makerPIF/Catamaran/daejeon-ESP32usv/daejeon-ESPusv/docs/01-HARDWARE.md

# 01 · 하드웨어

[← 저장소 홈으로](../README.md)

- [1. A2212 10T 1400KV 적합성 검증](#1-a2212-10t-1400kv-적합성-검증)
- [2. 프로펠러 선정](#2-프로펠러-선정)
- [3. 부품표 (BOM)](#3-부품표-bom)
- [3-1. 카메라 보드 — 둘 중 무엇을 쓸까](#3-1-카메라-보드--둘-중-무엇을-쓸까)
- [4. ESP32 핀 배치](#4-esp32-핀-배치)
- [5. 전원 계통](#5-전원-계통)
- [6. 배터리 전압 측정 회로](#6-배터리-전압-측정-회로)
- [7. ESC를 후진 가능하게 만들기](#7-esc를-후진-가능하게-만들기)

---

## 1. A2212 10T 1400KV 적합성 검증

결론부터 — **"어디에 다느냐"에 따라 답이 정반대로 갈립니다.**

### ✅ 수면 위 에어프로펠러(에어보트) 방식 — 적합

A2212 10T 1400KV는 원래 소형 비행기·드론용 아웃러너입니다. **공기를 미는 프로펠러를 돌리는 것이
이 모터의 설계 목적**이므로, 3S 배터리 + 8×4.5″ 프로펠러 조합에서 정격 안쪽으로 여유 있게 동작합니다.

### ❌ 수중 프로펠러 직결 방식 — 쓰지 말 것

두 가지 이유입니다.

1. **구조** — 아웃러너는 케이스가 열려 있어 물이 그대로 들어갑니다. 방수 코팅을 해도 베어링과 권선이 곧 부식됩니다.
2. **부하** — 물은 공기보다 약 800배 무겁습니다. 1400KV의 고회전·저토크 특성으로 수중 프로펠러를
   돌리면 전류가 정격을 크게 넘겨 모터와 ESC가 함께 타버립니다.

수중 추진에는 500~900KV 저KV 방수 모터를 씁니다. 중학생 초심자에게는 방수 처리·스터핑 박스·축 정렬이
모두 난관이라 이 프로젝트에서는 선택하지 않았습니다.

### 계산으로 확인하기

| 항목 | 계산 | 결과 | 기준 | 판정 |
|---|---|---|---|---|
| 모터 1개 최대 전력 | `11.1 V × 13 A` | **144.3 W** | 정격 180 W | ✅ 여유 20 % |
| ESC 전류 여유율 | `30 A ÷ 13 A` | **2.31 배** | 1.5배 이상 | ✅ 충분 |
| 총 정지 추력 | `780 gf × 2` | **1,560 gf** | — | — |
| 추력 대 중량비 | `1,560 gf ÷ 2.4 kg` | **0.62** | 0.3 이상 | ✅ 2배 여유 |
| 순항(55 %) 소비전류 | `13 A × 2 × 0.55³ + 0.6 A` | **4.9 A** | — | — |
| 실운용 시간 | `5.0 Ah ÷ 4.9 A × 0.8 × 0.7` | **34 분** | 15분 이상 | ✅ 양호 |
| 무부하 최대 회전수 | `1400 KV × 11.1 V` | **15,540 rpm** | — | ⚠ 가드 필수 |

> 배는 항공기와 달리 추력/중량비가 1을 넘길 필요가 없습니다. 물 위에 뜬 상태에서 **항주 저항만
> 이기면 되므로 0.3 이상이면 충분**합니다. 0.62는 가속과 맞바람에 쓸 여유가 두 배라는 뜻입니다.

추력·전류는 A2212 1400KV + 8×4.5″ + 3S 조합의 공개 실측 참고치입니다.
`hardware/대전중앙중_USV_BOM.xlsx` 의 **추진성능계산** 시트에서 노란 칸을 바꾸면 전부 다시 계산됩니다.
완성 후 주방저울로 실제 추력을 재서 그 값을 우리 기체 실측치로 바꾸면 정확해집니다.

---

## 2. 프로펠러 선정

| 프로펠러 | 배터리 | 추력/개 | 전류/개 | 평가 |
|---|---|---|---|---|
| **8045 (8×4.5″)** | 3S | ≈780 gf | ≈13 A | ✅ **1순위 · 표준 조합.** 추력·전류·소음의 균형이 가장 좋습니다 |
| 8060 (8×6″) | 3S | ≈850 gf | ≈15 A | 🟡 2순위. 최고속도는 조금 오르지만 발열이 커집니다. 3S에서의 상한선 |
| 7038 (7×3.8″) | 3S | ≈580 gf | ≈9 A | 🟡 장시간 운용용. 추력을 줄이는 대신 운용시간이 1.4배 늘어납니다 |
| 1045 (10×4.5″) | **2S 전용** | ≈520 gf | ≈10 A | ❌ **3S 금지.** 3S에 물리면 18~20 A로 정격을 넘겨 모터가 탑니다 |

> [!IMPORTANT]
> **좌·우에 CW(정회전) 1개, CCW(역회전) 1개를 나눠 다세요.**
> 두 프로펠러가 같은 방향으로 돌면 반작용 토크가 한쪽으로 쌓여 배가 계속 한쪽으로 기울고 돌아갑니다.
> 허브는 `3.17 mm`, 재질은 나일론+유리섬유(물 튀김·충격에 강함)를 고르세요.

> [!WARNING]
> 15,540 rpm으로 도는 프로펠러는 손가락을 벱니다. **프로펠러 가드 없이는 절대 전원을 넣지 마세요.**
> 가드는 3D 프린팅으로 함께 출력합니다([02-BUILD.md](02-BUILD.md)).

---

## 3. 부품표 (BOM)

전체 48개 품목과 소계·예산 비율은 [`hardware/대전중앙중_USV_BOM.xlsx`](../hardware/대전중앙중_USV_BOM.xlsx) 에 있습니다.
(`hardware/build_bom.py` 를 실행하면 다시 생성됩니다.)

★ 표시는 안전 또는 성능상 반드시 지켜야 하는 항목입니다.

### A. 추진계 — 90,800원

| 부품 | 규격 | 수량 | 단가 | 비고 |
|---|---|---:|---:|---|
| BLDC 모터 A2212 10T | 1400KV / 2–3S / 180W·14A / 축 3.17mm | 2 | 13,000 | ★ 에어프로펠러 전용 |
| ESC 30A (BLHeli_S) | 2–4S, BEC 5V 2A | 2 | 18,000 | ★ BLHeli_S여야 3D 모드 가능 |
| 프로펠러 8045 CW/CCW | 8×4.5″ 나일론+GF, 허브 3.17mm | 3세트 | 4,000 | 파손 대비 여유분 |
| BLHeli USB 링커 | SILABS C2 / 1-wire | 1 | 12,000 | 팀당 1개면 충분 |
| 3.5mm 바나나 커넥터 | 금도금 암/수 | 6 | 800 | 모터–ESC 연결 |
| 모터 마운트 (3D 프린팅) | PETG, 16mm 볼트 패턴 | 2 | — | 자체 제작 |
| 프로펠러 안전 가드 (3D 프린팅) | 내경 Ø225mm | 2 | — | ★ 안전상 필수 |

### B. 제어·센서 — 86,300원

| 부품 | 규격 | 수량 | 단가 |
|---|---|---:|---:|
| ESP32 NodeMCU DevKit V1 | ESP32-WROOM-32, 30핀 | 1 | 12,000 |
| MPU6050 (GY-521) | 6축 IMU, I2C | 1 | 3,000 |
| u-blox NEO-8M GPS | 세라믹 안테나 포함, 9600bps | 1 | 22,000 |
| 카메라 보드 ⓐ XIAO ESP32S3 Sense | OV2640 + PSRAM 8MB | 1 | 32,000 |
| 카메라 보드 ⓑ ESP32-CAM AI-Thinker | OV2640 + PSRAM 4MB (+ USB-TTL 어댑터 7,000원) | 1 | 9,000 |
| 능동 부저 5V | 3.3V 구동 가능형 | 1 | 1,000 |
| 저항 100kΩ / 22kΩ (1%) | 1/4W | 4 | 200 |
| 만능기판 + 핀헤더 + 점퍼선 | 5×7cm | 1 | 8,000 |
| XT60 커넥터 암/수 | — | 3 | 2,500 |

### C. 전원 — 195,000원

| 부품 | 규격 | 수량 | 단가 | 비고 |
|---|---|---:|---:|---|
| LiPo 배터리 3S 5000mAh 30C | 11.1V, XT60 | 2 | 55,000 | ★ 3S 고정 |
| UBEC 5V 3A (스위칭) | 입력 2–6S | 2 | 9,000 | 전원 계통 분리용 |
| LiPo 밸런스 충전기 | IMAX B6 급 | 1 | 45,000 | 학교 보유 시 제외 |
| 방수 토글 스위치 | 12V 20A 이상 | 1 | 4,000 | |
| XT60 병렬 분배 하네스 | 1→3 분기 | 1 | 6,000 | |
| LiPo 안전 보관 가방 | 방염 | 1 | 8,000 | ★ 안전상 필수 |
| 배터리 잔량 체커 | 1–8S | 1 | 4,000 | |

### D. 통신 — 246,000원

| 부품 | 규격 | 수량 | 단가 | 비고 |
|---|---|---:|---:|---|
| 미니 공유기 GL.iNet GL-AR300M16-Ext | OpenWrt / 외장안테나 2 / 5V | 1 | 45,000 | USV 탑재 |
| 2.4GHz 5dBi 무지향 안테나 | RP-SMA | 2 | 6,000 | USV 측 |
| 지상국 USB 무선랜 | ALFA AWUS036NHA 급 | 1 | 55,000 | ★ 장거리의 핵심 |
| 2.4GHz 14dBi 지향성 패널 | RP-SMA, 실외형 | 1 | 35,000 | ★ USV를 향해 조준 |
| RP-SMA 저손실 케이블 3m | LMR-195 급 | 2 | 12,000 | 짧을수록 좋음 |
| 안테나 거치용 삼각대 | 1.5m 이상 | 1 | 25,000 | 높이 = 통달거리 |
| [선택] LoRa E22-900T22S | 920MHz 설정 필수 | 2 | 18,000 | 백업 텔레메트리 |
| [선택] 920MHz 안테나 | 3dBi SMA | 2 | 7,000 | |

### E. RC 조종 — 90,000원

| 부품 | 규격 | 수량 | 단가 | 비고 |
|---|---|---:|---:|---|
| FlySky FS-i6 + FS-iA6B | 2.4GHz 6채널, iBUS | 1 | 85,000 | ★ 비상 정지·수동 탈출 |
| AA 건전지 | 송신기용 | 4 | 5,000 | |

### F. 선체·기구 — 192,200원 / G. 공구·소모품 — 87,000원

PETG 필라멘트 3kg(84,000), TPU 0.5kg(25,000), IP65 인클로저(18,000), 케이블 그랜드 PG7 ×6,
알루미늄 각파이프 20×20 ×2, EPP 폼, M3 볼트·인서트 너트, 실리콘 실란트, 부틸 테이프, 벨크로.
공구는 납땜인두·열수축튜브·멀티미터·드라이버 세트·주방저울 5kg(추력 측정용).

---

## 3-1. 카메라 보드 — 둘 중 무엇을 쓸까

영상 모듈은 **ⓐ XIAO ESP32S3 Sense** 와 **ⓑ ESP32-CAM AI-Thinker** 두 가지를 모두 지원합니다.
펌웨어 파일만 골라 올리면 되고, 주소 체계(`192.168.8.30` · `/stream` · `/control`)가 같아서
**GCS는 전혀 고칠 필요가 없습니다.**

| 항목 | ⓐ XIAO ESP32S3 Sense | ⓑ ESP32-CAM AI-Thinker |
|---|---|---|
| 가격 | 약 32,000원 | 약 9,000원 (+ USB-TTL 7,000원) |
| USB 단자 | **있음** — 케이블만 꽂으면 업로드 | 없음 — FTDI 어댑터 필수 |
| 업로드 난이도 | 쉬움 | IO0–GND 점프 필요 |
| 외장 안테나 | 기본 제공 (커넥터 바로 사용) | 가능하지만 **납땜 개조** 필요 |
| 크기 / 무게 | 21 × 17 mm / 약 5 g | 40 × 27 mm / 약 20 g |
| PSRAM | 8 MB | 4 MB |
| 전원 민감도 | 둔감 | **매우 민감** (470 µF 커패시터 권장) |
| 발열 | 적음 | 많음 (방열판 권장) |
| 플래시 LED | 없음 | **있음** (GPIO4) — 저조도 회수용 탐조등 |
| 펌웨어 | `usv_cam_xiao.ino` | `usv_cam_esp32cam.ino` |

**이렇게 고르세요.**

- 처음 만드는 팀, 중학생이 직접 납땜한다면 → **ⓐ XIAO**.
  USB로 바로 업로드되고 전원 문제가 거의 없습니다. 실패할 구석이 적습니다.
- 예산을 아껴야 하거나 여러 대를 만든다면 → **ⓑ ESP32-CAM**.
  대당 2만원 넘게 절약되고, USB-TTL 어댑터는 팀당 1개만 있으면 됩니다.
- 이미 학교에 ESP32-CAM이 굴러다닌다면 → 당연히 **ⓑ**.
  메이커 교육 현장에서 가장 흔한 보드이기도 합니다.

> [!NOTE]
> BOM의 예산 합계(987,300원)는 ⓐ XIAO 기준입니다.
> ⓑ ESP32-CAM으로 바꾸면 **약 16,000원이 줄어듭니다.**

---

## 4. ESP32 핀 배치

| 핀 | 연결 대상 | 선 색 (일반) | 비고 |
|---|---|---|---|
| `GPIO25` | 좌현 ESC 신호 | 흰색 또는 노랑 | PWM 50 Hz |
| `GPIO26` | 우현 ESC 신호 | 흰색 또는 노랑 | PWM 50 Hz |
| `GPIO21` | MPU6050 SDA | — | I2C 400 kHz |
| `GPIO22` | MPU6050 SCL | — | — |
| `GPIO16` | NEO-8M 의 **TX** | — | 서로 엇갈려 연결 (RX↔TX) |
| `GPIO17` | NEO-8M 의 **RX** | — | 9600 bps |
| `GPIO4` | FS-iA6B 의 iBUS(SENS) 단자 | — | 신호선 1가닥만 |
| `GPIO34` | 전압 분배 회로 중점 | — | 입력 전용 핀 |
| `GPIO27` | 부저 (+) | — | — |
| `3V3` | MPU6050 VCC | 빨강 | 5V도 되지만 3.3V 권장 |
| `VIN` | UBEC #1 의 5V | 빨강 | — |
| `GND` | **모든 GND 공통** | 검정 | ESC·수신기·센서 전부 |

> [!CAUTION]
> **가장 흔한 실수 — ESC 두 개의 BEC(빨간 선)를 동시에 연결하지 마세요.**
> 두 ESC의 5V 출력이 서로 다른 값을 밀어내며 싸우다가 한쪽이 고장납니다.
> ESC 신호 커넥터 3가닥 중 **빨간 선을 뽑아서 절연**하고, 흰색(신호)과 검정(GND)만 ESP32에 연결하세요.
> 5V는 UBEC에서 받습니다.

---

## 5. 전원 계통

```
3S LiPo (11.1V 5000mAh)
   │
   └─[메인 스위치]─[XT60 분배]─┬─────────────────► ESC ×2  (11.1V 직결, BEC 빨간선 제거)
                              │
                              ├─[UBEC #1 → 5V 3A]─┬─► ESP32 (VIN)
                              │                    └─► MPU6050 · NEO-8M · FS-iA6B 수신기
                              │
                              └─[UBEC #2 → 5V 3A]─┬─► 미니 공유기
                                                   └─► 카메라 보드
```

**UBEC를 두 개 쓰는 이유** — 공유기와 카메라는 순간 소비전류가 크게 출렁입니다.
ESP32와 같은 5V 선을 쓰면 그 출렁임에 컨트롤러가 리셋될 수 있어, 전원 계통을 아예 갈라 놓습니다.

---

## 6. 배터리 전압 측정 회로

ESP32의 ADC는 3.3 V까지만 읽으므로 11.1 V를 저항 두 개로 나눠 넣습니다.

```
배터리(+) ──[100 kΩ]──┬──[22 kΩ]── GND
                      │
                      └──────────► GPIO34
```

분배비 `(100 + 22) / 22 = 5.545` → 만충 12.6 V일 때 GPIO34에는 **2.27 V**가 걸립니다.
펌웨어의 `VBAT_DIV_RATIO` 값이 이 5.545입니다.

멀티미터 실측값과 GCS 표시값이 다르면 `VBAT_CAL` 을 `실측 ÷ 표시` 로 넣어 보정하세요.

---

## 7. ESC를 후진 가능하게 만들기

보통의 드론용 ESC는 한 방향으로만 돕니다. 후진을 하려면 ESC 펌웨어의
**Bidirectional(3D) 모드**를 켜야 합니다. **이 한 단계를 빼먹으면 배가 앞으로만 갑니다.**

### 3D 모드에서의 신호 규약

```
 1000 µs ◀──────────── 1500 µs ────────────▶ 2000 µs
 최대 후진            정지(중립)             최대 전진
                      ±30 µs 불감대
```

펌웨어의 `PULSE_NEUTRAL` / `PULSE_FWD_MAX` / `PULSE_REV_MAX` 가 이 값들입니다.
중립 부근 ±30 µs는 일부러 아무 출력도 내지 않는 구간으로 두어, 손을 뗐을 때 모터가 떨지 않게 합니다.

### 설정 절차

1. **BLHeliSuite 설치** — 검색해서 `BLHeliSuite`(BLHeli_S용)를 받습니다. 윈도우 전용입니다.
2. **ESC 연결** — USB 링커를 PC와 ESC 신호 커넥터에 연결하고, ESC에는 배터리로 전원을 넣습니다.
   (링커가 없다면 아두이노 나노에 `4-way interface` 스케치를 올려 대신 쓸 수 있습니다.)
3. **Read Setup** — 상단에서 인터페이스를 고르고 `Connect` → `Read Setup`.
4. **Motor Direction = Bidirectional** — 이것이 핵심 항목입니다.
5. **Programming by TX = Off** — 켜 두면 조종 신호로 설정이 바뀔 수 있습니다. 반드시 끕니다.
6. **Low RPM Power Protect = On** — 저속에서 모터가 헛도는 것을 막아줍니다.
7. **Write Setup** — 저장하고, 나머지 ESC 한 개도 똑같이 설정합니다.
8. **회전 방향 확인** — 프로펠러를 뺀 상태로 전원을 넣고 GCS에서 전진 명령을 줍니다.
   반대로 돌면 `Bidirectional Reversed`로 바꾸거나, 모터 3가닥 중 **아무 2가닥**을 서로 바꿔 끼웁니다.

> [!WARNING]
> 구입한 ESC가 BLHeli_S 펌웨어가 아니면(예: SimonK, 일반 Skywalker) 이 설정이 불가능합니다.
> 상품 설명에 **"BLHeli_S"** 가 있는지 사기 전에 꼭 확인하세요.

---

[→ 다음: 02-BUILD.md (제작)](02-BUILD.md)
