makerPIF/Catamaran/daejeon-ESP32usv/daejeon-ESPusv/docs/03-NETWORK.md

# 03 · 통신

[← 저장소 홈으로](../README.md) · [← 02-BUILD.md](02-BUILD.md)

- [1. 공유기 설정](#1-공유기-설정)
- [2. 통신 거리를 늘리는 법](#2-통신-거리를-늘리는-법)
- [3. 실전에서 지킬 것](#3-실전에서-지킬-것)
- [4. LoRa 백업 텔레메트리 (선택)](#4-lora-백업-텔레메트리-선택)
- [5. 통신은 반드시 끊긴다 — 페일세이프](#5-통신은-반드시-끊긴다--페일세이프)
- [6. 전파 규정](#6-전파-규정)

---

## 1. 공유기 설정

GL.iNet GL-AR300M16 기준입니다. 다른 기종도 메뉴 이름만 다를 뿐 순서는 같습니다.

| # | 단계 | 내용 |
|---|---|---|
| 1 | PC와 연결 | 5V 어댑터로 전원을 넣고 `GL-AR300M-xxx` Wi-Fi에 접속 → `http://192.168.8.1` → 관리자 비밀번호 설정 |
| 2 | **Wi-Fi 이름과 비밀번호** | Wireless → 2.4G Guest는 끄고, 2.4G 메인을 아래와 같이 설정 |
| 3 | 5GHz 끄기 | (해당 기종이 있다면) 2.4 GHz가 거리와 회절에 유리하고 전력도 아낍니다 |
| 4 | **채널 고정** | `Auto`가 아니라 **1, 6, 11 중 하나**로 고정, Bandwidth **20 MHz** 고정 |
| 5 | DHCP 범위 제한 | Network → LAN 에서 DHCP 시작 `100`, 끝 `150` (고정 IP와 충돌 방지) |
| 6 | 송신 출력 | Wireless → Advanced 에서 TX Power를 **규정 범위 안** 최대치로 |
| 7 | 안테나 교체 | 기본 안테나를 5 dBi로 바꾸고 마스트에 **수직으로 곧게** 세움 |
| 8 | 전원 배선 | UBEC #2의 5V를 공유기 DC 입력에. 케이블을 잘라 쓸 때 극성을 두 번 확인 |

```
SSID      : 대전중앙중학교
Password  : 2026USV
암호화    : WPA2-PSK
채널      : 1 / 6 / 11 중 현장에서 가장 한산한 것
대역폭    : 20 MHz 고정
```

> [!NOTE]
> 40 MHz는 속도는 빠르지만 **거리가 짧아지고 간섭에 약합니다.** USV에 필요한 것은
> 속도가 아니라 거리와 안정성이므로 20 MHz로 고정합니다.

> [!TIP]
> 대회장이나 학교 운동장에는 이미 Wi-Fi가 많습니다. 도착하면 스마트폰의 Wi-Fi 분석 앱으로
> **가장 한산한 채널을 찾아 그때그때 바꾸세요.** 채널 하나 옮기는 것만으로 통달거리가 눈에 띄게 달라집니다.

### TP-Link 계열을 쓸 경우

기본 대역이 `192.168.0.x` 입니다. 바꿔야 할 곳이 세 군데입니다.

| 파일 | 수정할 항목 |
|---|---|
| `firmware/usv_main_esp32/usv_main_esp32.ino` | `LOCAL_IP` → `192.168.0.20`, `GATEWAY` → `192.168.0.1` |
| `firmware/usv_cam_xiao/usv_cam_xiao.ino` | `LOCAL_IP` → `192.168.0.30`, `GATEWAY` → `192.168.0.1` |
| `gcs/index.html` | 화면 상단의 **본체 IP / 카메라 IP** 입력칸 (코드 수정 불필요) |

---

## 2. 통신 거리를 늘리는 법

거리를 버는 방법은 크게 셋입니다 — **안테나를 높이 올리고, 이득이 큰 안테나를 쓰고,
보내는 데이터를 줄이는 것.** 셋 다 무료이거나 저렴하고, 셋 다 합법입니다.

| 단계 | 무엇을 하나 | 예상 거리 | 비용 |
|---|---|---|---|
| 기준 | 기본 안테나 + 노트북 내장 Wi-Fi, 지면 높이 | 80 ~ 150 m | 0원 |
| **1단계** | 양쪽 5 dBi 안테나 + 지상 안테나를 삼각대로 1.5 m 이상 | 200 ~ 350 m | 3만원 |
| **2단계** | 지상국에 14 dBi 지향성 패널 + 고출력 USB 무선랜 | **600 m ~ 1.2 km** | 9만원 |
| **3단계** | 채널·대역폭 최적화, 영상 해상도 낮추기 | 2단계의 1.3배 | 0원 |
| 보조 | LoRa 920 MHz 백업 (센서·명령만, 영상 제외) | 1 ~ 3 km | 5만원 |

**권장 조합: 1 + 2 + 3 을 함께 적용** — 약 12만원 추가로 1 km 급을 확보합니다.

---

## 3. 실전에서 지킬 것

### 편파를 맞추세요

USV 안테나와 지상 안테나를 **둘 다 수직**으로 세웁니다. 한쪽만 눕혀도 신호가 크게 깎입니다.
배가 파도에 기울면 그만큼 손해라는 뜻이기도 합니다.

> 시뮬레이션에서 이 효과를 재현해 두었습니다. `파고`를 올리면 롤이 커지면서 RSSI가 같이 흔들립니다.

### 수면 위 높이가 곧 거리입니다

물은 전파를 반사해 서로 상쇄시킵니다. 지상 안테나를 삼각대로 **1.5~2 m** 올리고,
USV 안테나도 마스트로 데크에서 **30 cm 이상** 띄우세요.

### 지향성 안테나는 조준해야 합니다

14 dBi 패널의 빔 폭은 약 **30°** 입니다. 배를 따라 안테나를 돌려 줄 학생을 한 명 지정하세요.
이 역할이 **통신 담당**입니다.

### 케이블은 짧게

2.4 GHz에서 동축 케이블은 1 m당 대략 **0.6~1 dB**를 잃습니다.
5 m 케이블 대신 3 m를 쓰고, 무선랜 어댑터를 안테나 가까이 두세요.

### 영상이 조종을 밀어냅니다

멀어지면 GCS에서 해상도를 `QVGA`로 낮추세요. 영상이 대역폭을 다 먹으면 조종 명령과 텔레메트리가
늦게 도착합니다. **화질보다 조종이 우선입니다.**

### 사람 몸도 장애물입니다

지향성 안테나 앞에 서지 마세요.

---

## 4. LoRa 백업 텔레메트리 (선택)

Wi-Fi가 끊기면 배가 어디 있는지조차 알 수 없게 됩니다.
920 MHz LoRa 모듈 두 개를 붙여 **위치 · 전압 · 비상정지** 세 가지만 오가는 백업 채널을 만들면,
Wi-Fi 밖으로 나가도 배를 찾아올 수 있습니다.

| 항목 | 값 |
|---|---|
| 모듈 | E22-900T22S 등 920 MHz 대역 |
| 대역 | **917 ~ 923.5 MHz** (국내 비면허 소출력) |
| 전송 내용 | 위도·경도·전압·비상정지 명령 (영상 제외) |
| 예상 거리 | 1 ~ 3 km |

> [!CAUTION]
> 해외 직구품의 **868 MHz(유럽)·915 MHz(미국) 기본 설정을 그대로 쓰면 안 됩니다.**
> 반드시 920 MHz 대역 채널로 설정하고, 가능하면 국내 적합성평가(KC) 인증 제품을 사용하세요.

---

## 5. 통신은 반드시 끊긴다 — 페일세이프

거리를 아무리 늘려도 언젠가는 끊깁니다. 그래서 펌웨어에 이렇게 넣어 두었습니다.

| 상황 | 판정 시간 | 동작 |
|---|---|---|
| GCS 명령 끊김 | **1.5 초** | 모터 중립 정지 |
| RC 신호 끊김 | **1.0 초** | RC 모드였다면 정지 |
| 배터리 10.2 V 이하 | 즉시 | 정지 + 시동 해제 + 경보 5초 유지 |
| 롤 70° 초과 (전복) | 즉시 | 정지 + 시동 해제 + 경보 5초 유지 |

GCS 쪽에도 감시견을 두었습니다. **텔레메트리가 2초 이상 끊기면** 연결 표시가
`신호 없음`으로 바뀌고 상태 타일이 흐려집니다.

통신 두절 표시

마지막 값이 그대로 남아 "아직 살아 있는 것처럼" 보이는 상황을 막기 위한 장치입니다.
시뮬레이션 상황 ⑥번으로 직접 확인할 수 있습니다.

> 그래도 배가 멀리 나가 멈춰 버릴 수 있습니다. **회수용 보트나 긴 로프를 반드시 준비하세요.**

---

## 6. 전파 규정

> [!WARNING]
> **Wi-Fi 송신 출력을 규정 이상으로 올리는 개조(파워 부스터 등)는 전파법 위반입니다.**
> 출력이 아니라 **안테나 이득과 높이**로 거리를 버세요. 효과도 이쪽이 훨씬 큽니다.

- 2.4 GHz ISM 대역은 비면허로 쓸 수 있지만 **기기 출력과 안테나 이득의 합(EIRP)에 상한**이 있습니다.
- 920 MHz(917~923.5 MHz) 대역은 국내에서 비면허 소출력 무선기기용으로 개방되어 있습니다.
- 대회·공개 시연에서는 **적합성평가(KC) 인증을 받은 제품**을 쓰는 것이 안전합니다.
- 운용하는 지역의 최신 법령을 반드시 직접 확인하세요. 이 문서는 참고 자료일 뿐입니다.

---

[→ 다음: 04-GCS.md (지상관제소)](04-GCS.md)
